aaariyann/Analog-Line-Follower/Anlog_LFR.kicad_pcb

## KiCad design Anlog_LFR.kicad_pcb (2026-10-10)

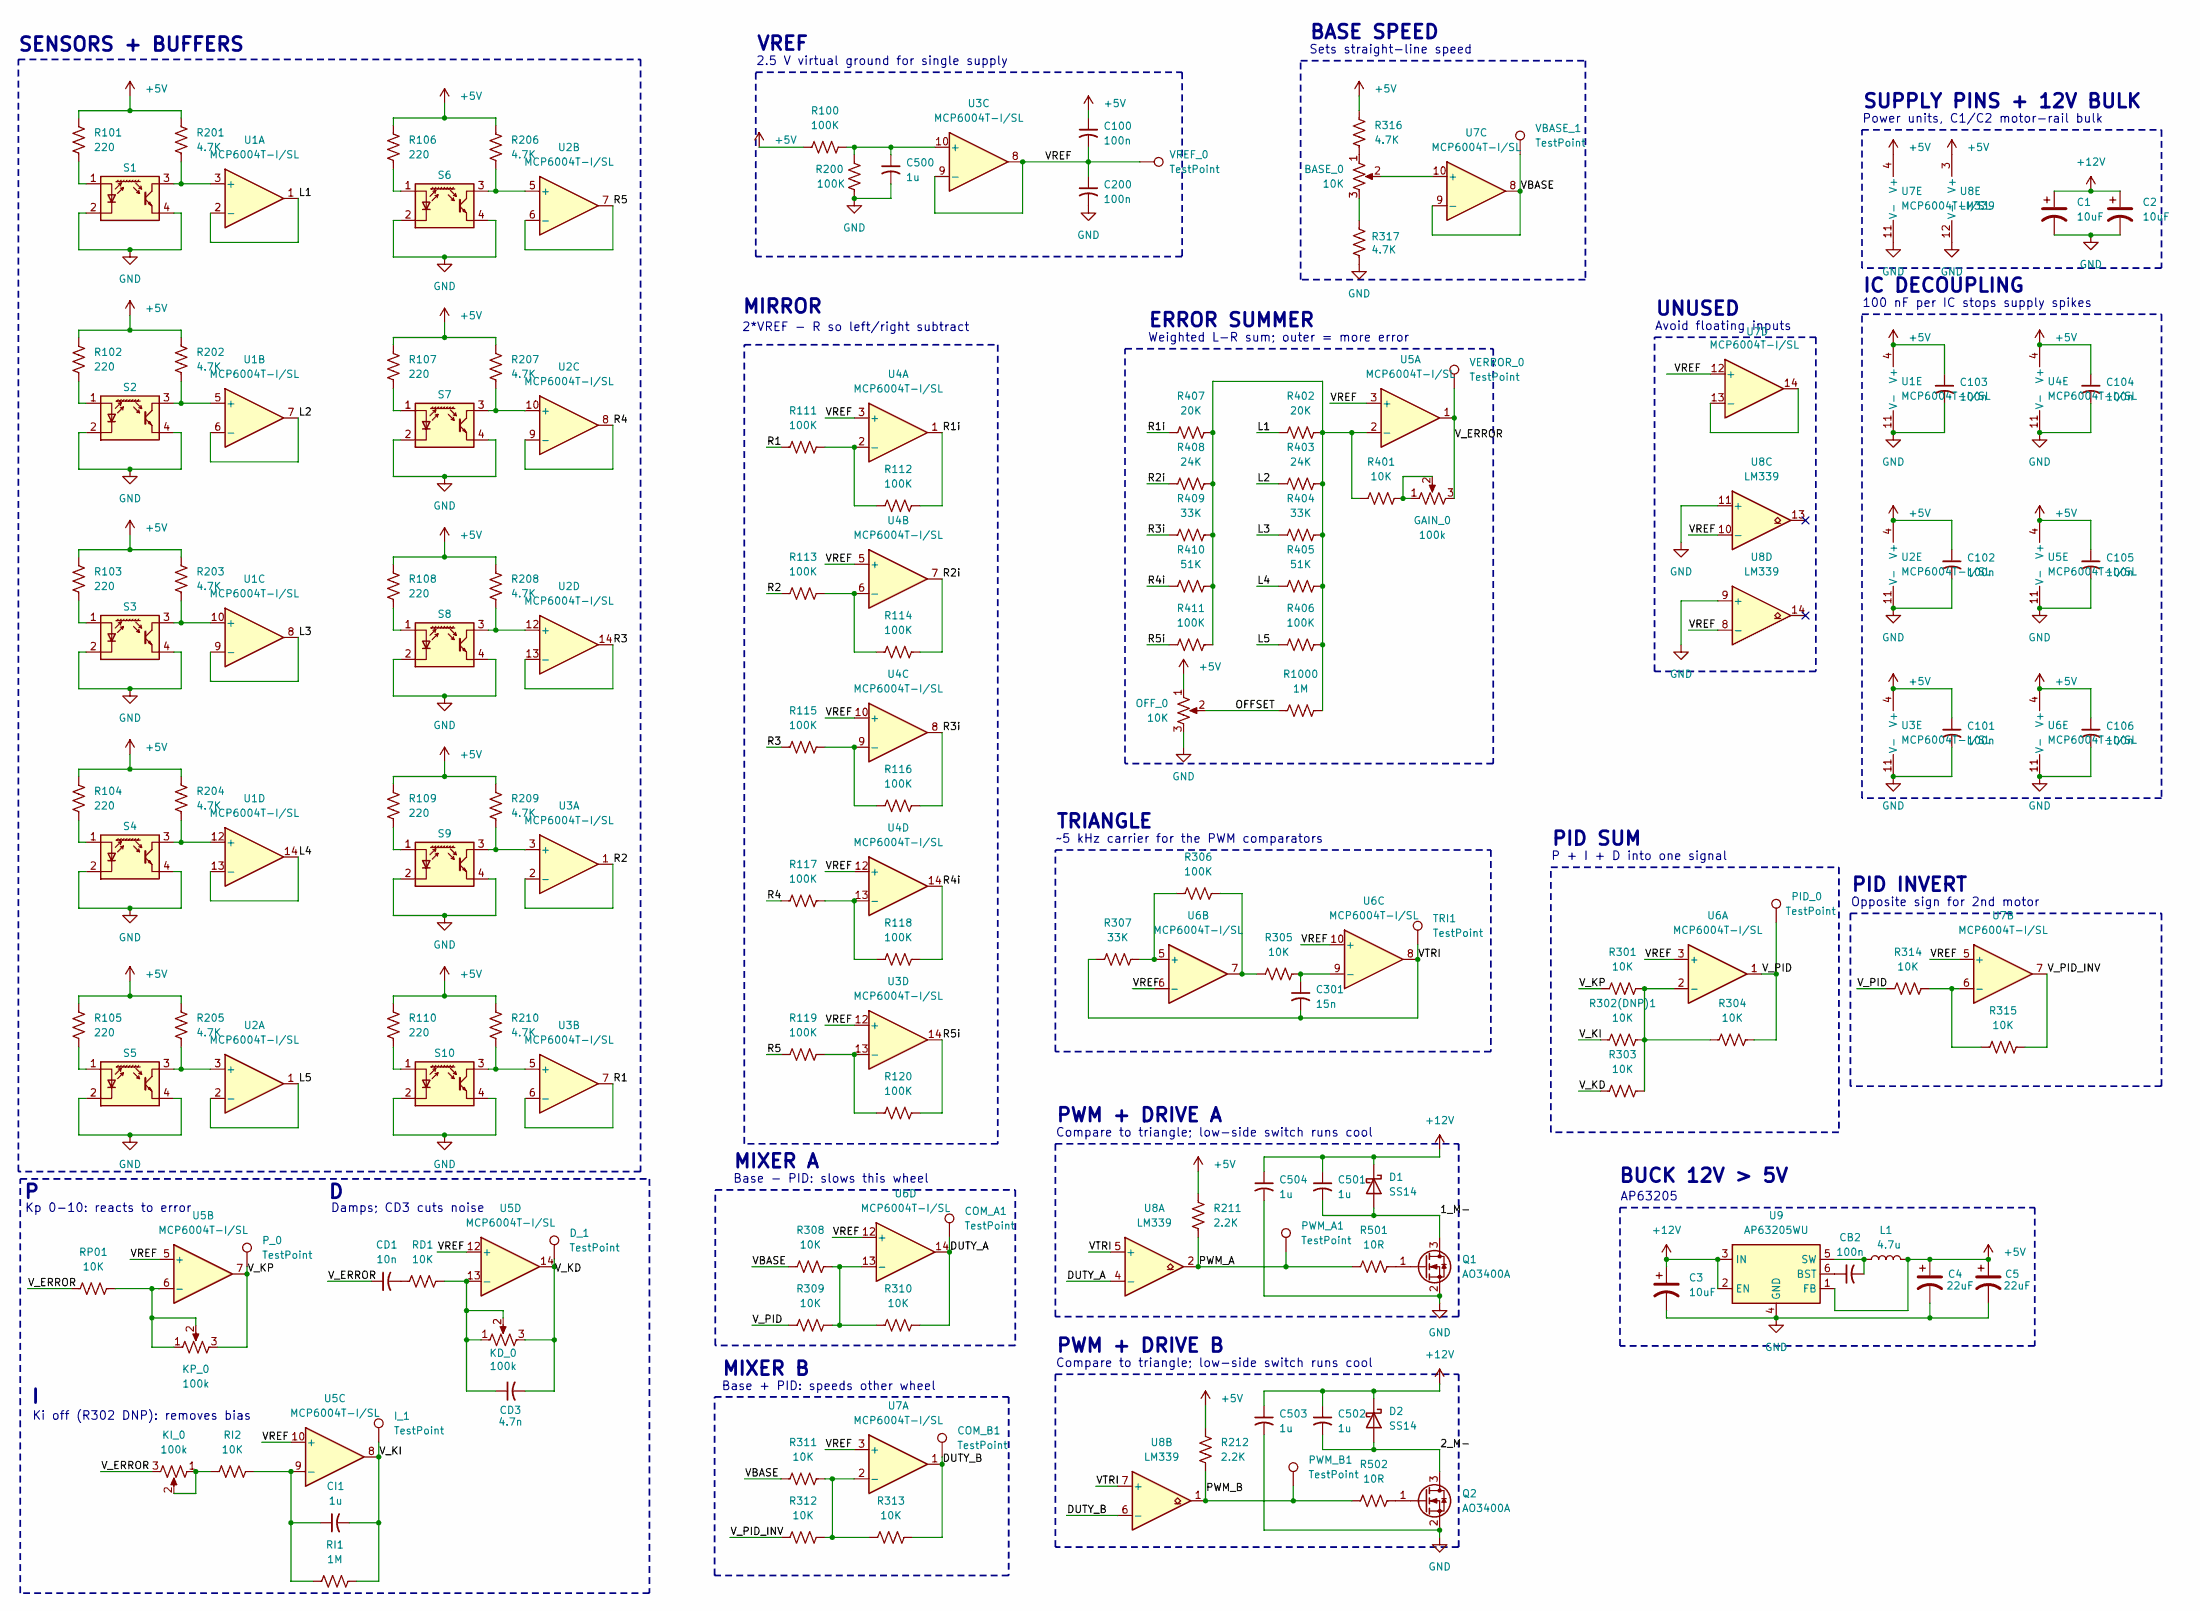
[picture p1: schematic Analog_LFR.kicad_sch, Analog PID Line Follower]

Parts:
BASE_0: 10K; Potentiometer_Bourns_3224W_Vertical
C1, C2: 10uF; CP_Elec_5x5.4
C3: 10uF; C_1206_3216Metric_Pad1.33x1.80mm_HandSolder
C4, C5: 22uF; C_1206_3216Metric_Pad1.33x1.80mm_HandSolder
C100, C101, C102, C103, C104, C105, C106, C200: 100n; C_1206_3216Metric_Pad1.33x1.80mm_HandSolder
C301: 15n; C_0805_2012Metric_Pad1.18x1.45mm_HandSolder
C500, C501, C502, C503, C504: 1u; C_0805_2012Metric_Pad1.18x1.45mm_HandSolder
CB2: 100n; C_1206_3216Metric_Pad1.33x1.80mm_HandSolder
CD1: 10n; C_1206_3216Metric_Pad1.33x1.80mm_HandSolder
CD3: 4.7n; C_1206_3216Metric_Pad1.33x1.80mm_HandSolder
CI1: 1u; C_0805_2012Metric_Pad1.18x1.45mm_HandSolder
COM_A1: TestPoint; TestPoint_Pad_D2.0mm
COM_B1: TestPoint; TestPoint_Pad_D2.0mm
D1, D2: SS14; D_SMA
D_1: TestPoint; TestPoint_Pad_D2.0mm
GAIN_0: 100k; Potentiometer_Bourns_3224W_Vertical
I_1: TestPoint; TestPoint_Pad_D2.0mm
KD_0: 100k; Potentiometer_Bourns_3224W_Vertical
KI_0: 100k; Potentiometer_Bourns_3224W_Vertical
KP_0: 100k; Potentiometer_Bourns_3224W_Vertical
L1: 4.7u; L_7.3x7.3_H3.5
OFF_0: 10K; Potentiometer_Bourns_3224W_Vertical
PID_0: TestPoint; TestPoint_Pad_D2.0mm
PWM_A1: TestPoint; TestPoint_Pad_D2.0mm
PWM_B1: TestPoint; TestPoint_Pad_D2.0mm
P_0: TestPoint; TestPoint_Pad_D2.0mm
Q1, Q2: AO3400A; SOT-23-3
R100, R111, R112, R113, R114, R115, R116, R117, R118, R119, R120, R200, R306, R406, R411: 100K; R_1206_3216Metric_Pad1.30x1.75mm_HandSolder
R101, R102, R103, R104, R105, R106, R107, R108, R109, R110: 220; R_1206_3216Metric_Pad1.30x1.75mm_HandSolder
R201, R202, R203, R204, R205, R206, R207, R208, R209, R210, R316, R317: 4.7K; R_1206_3216Metric_Pad1.30x1.75mm_HandSolder
R211, R212: 2.2K; R_1206_3216Metric_Pad1.30x1.75mm_HandSolder
R301, R302(DNP)1, R303, R304, R305, R308, R309, R310, R311, R312, R313, R314, R315, R401: 10K; R_1206_3216Metric_Pad1.30x1.75mm_HandSolder
R307, R404, R409: 33K; R_1206_3216Metric_Pad1.30x1.75mm_HandSolder
R402, R407: 20K; R_1206_3216Metric_Pad1.30x1.75mm_HandSolder
R403, R408: 24K; R_1206_3216Metric_Pad1.30x1.75mm_HandSolder
R405, R410: 51K; R_1206_3216Metric_Pad1.30x1.75mm_HandSolder
R501, R502: 10R; R_1206_3216Metric_Pad1.30x1.75mm_HandSolder
R1000: 1M; R_1206_3216Metric_Pad1.30x1.75mm_HandSolder
RD1: 10K; R_1206_3216Metric_Pad1.30x1.75mm_HandSolder
RI1: 1M; R_1206_3216Metric_Pad1.30x1.75mm_HandSolder
RI2: 10K; R_1206_3216Metric_Pad1.30x1.75mm_HandSolder
RP01: 10K; R_1206_3216Metric_Pad1.30x1.75mm_HandSolder
S1, S2, S3, S4, S5, S6, S7, S8, S9, S10: QRE1113GR; OnSemi_CASE100CY
TRI1: TestPoint; TestPoint_Pad_D2.0mm
U1, U2, U3, U4, U5, U6, U7: MCP6004T-I/SL; SOIC-14_3.9x8.7mm_P1.27mm
U8: LM339; SOIC-14_3.9x8.7mm_P1.27mm
U9: AP63205WU; TSOT-23-6
VBASE_1: TestPoint; TestPoint_Pad_D2.0mm
VERROR_0: TestPoint; TestPoint_Pad_D2.0mm
VREF_0: TestPoint; TestPoint_Pad_D2.0mm

Connections:
+5V: C4.1, C5.1, C100.1, C101.1, C102.1, C103.1, C104.1, C105.1, C106.1, L1.2, OFF_0.1, R100.1, R101.1, R102.1, R103.1, R104.1, R105.1, R106.1, R107.1, R108.1, R109.1, R110.1, R201.2, R202.2, R203.2, R204.2, R205.2, R206.2, R207.2, R208.2, R209.2, R210.2, R211.2, R212.2, R316.2, U1.4 (V+), U2.4 (V+), U3.4 (V+), U4.4 (V+), U5.4 (V+), U6.4 (V+), U7.4 (V+), U8.3 (V+), U9.1 (FB)
+12V: C1.1, C2.1, C3.1, C501.1, C502.1, C503.1, C504.1, D1.1 (K), D2.1 (K), U9.2 (EN), U9.3 (IN)
/1_M-: C501.2, D1.2 (A), Q1.3 (D)
/2_M-: C502.2, D2.2 (A), Q2.3 (D)
/DUTY_A: COM_A1.1 (1_1), R310.2, U6.14, U8.4 (-)
/DUTY_B: COM_B1.1 (1_1), R313.2, U7.1, U8.6 (-)
/L1: R402.1, U1.1, U1.2 (-)
/L2: R403.1, U1.6 (-), U1.7
/L3: R404.1, U1.8, U1.9 (-)
/L4: R405.1, U1.13 (-), U1.14
/L5: R406.1, U2.1, U2.2 (-)
/OFFSET: OFF_0.2, R1000.1
/PWM_A: PWM_A1.1 (1_1), R211.1, R501.1, U8.2
/PWM_B: PWM_B1.1 (1_1), R212.1, R502.1, U8.1
/R1: R111.1, U3.6 (-), U3.7
/R1i: R112.2, R407.1, U4.1
/R2: R113.1, U3.1, U3.2 (-)
/R2i: R114.2, R408.1, U4.7
/R3: R115.1, U2.13 (-), U2.14
/R3i: R116.2, R409.1, U4.8
/R4: R117.1, U2.8, U2.9 (-)
/R4i: R118.2, R410.1, U4.14
/R5: R119.1, U2.6 (-), U2.7
/R5i: R120.2, R411.1, U3.14
/VBASE: R308.1, R311.1, U7.8, U7.9 (-), VBASE_1.1 (1_1)
/VREF: C100.2, C200.1, U3.8, U3.9 (-), U3.12 (+), U4.3 (+), U4.5 (+), U4.10 (+), U4.12 (+), U5.3 (+), U5.5 (+), U5.10 (+), U5.12 (+), U6.3 (+), U6.6 (-), U6.10 (+), U6.12 (+), U7.3 (+), U7.5 (+), U7.12 (+), U8.8 (-), U8.10 (-), VREF_0.1 (1_1)
/VTRI: C301.2, R307.1, TRI1.1 (1_1), U6.8, U8.5 (+), U8.7 (+)
/V_ERROR: CD1.1, GAIN_0.3, KI_0.3, RP01.1, U5.1, VERROR_0.1 (1_1)
/V_KD: CD3.2, D_1.1 (1_1), KD_0.3, R303.1, U5.14
/V_KI: CI1.2, I_1.1 (1_1), R302(DNP)1.1, RI1.2, U5.8
/V_KP: KP_0.3, P_0.1 (1_1), R301.1, U5.7
/V_PID: PID_0.1 (1_1), R304.2, R309.1, R314.1, U6.1
/V_PID_INV: R312.1, R315.2, U7.7
GND: C1.2, C2.2, C3.2, C4.2, C5.2, C101.2, C102.2, C103.2, C104.2, C105.2, C106.2, C200.2, C500.2, C503.2, C504.2, OFF_0.3, Q1.2 (S), Q2.2 (S), R200.2, R317.1, S1.2 (K), S1.4, S2.2 (K), S2.4, S3.2 (K), S3.4, S4.2 (K), S4.4, S5.2 (K), S5.4, S6.2 (K), S6.4, S7.2 (K), S7.4, S8.2 (K), S8.4, S9.2 (K), S9.4, S10.2 (K), S10.4, U1.11 (V-), U2.11 (V-), U3.11 (V-), U4.11 (V-), U5.11 (V-), U6.11 (V-), U7.11 (V-), U8.9 (+), U8.11 (+), U8.12 (V-), U9.4 (GND)
unnamed: BASE_0.1, R316.1
unnamed: BASE_0.3, R317.2
unnamed: CD1.2, RD1.1
unnamed: GAIN_0.1, GAIN_0.2, R401.2
unnamed: KI_0.1, KI_0.2, RI2.1
unnamed: Q1.1 (G), R501.2
unnamed: Q2.1 (G), R502.2
unnamed: R305.1, R306.2, U6.7
unnamed: R101.2, S1.1 (A)
unnamed: R102.2, S2.1 (A)
unnamed: R103.2, S3.1 (A)
unnamed: R104.2, S4.1 (A)
unnamed: R105.2, S5.1 (A)
unnamed: R106.2, S6.1 (A)
unnamed: R107.2, S7.1 (A)
unnamed: R108.2, S8.1 (A)
unnamed: R109.2, S9.1 (A)
unnamed: R110.2, S10.1 (A)
unnamed: R201.1, S1.3, U1.3 (+)
unnamed: R202.1, S2.3, U1.5 (+)
unnamed: R203.1, S3.3, U1.10 (+)
unnamed: R204.1, S4.3, U1.12 (+)
unnamed: R205.1, S5.3, U2.3 (+)
unnamed: R206.1, S6.3, U2.5 (+)
unnamed: R207.1, S7.3, U2.10 (+)
unnamed: R208.1, S8.3, U2.12 (+)
unnamed: R209.1, S9.3, U3.3 (+)
unnamed: R210.1, S10.3, U3.5 (+)
unnamed: C500.1, R100.2, R200.1, U3.10 (+)
unnamed: R119.2, R120.1, U3.13 (-)
unnamed: R111.2, R112.1, U4.2 (-)
unnamed: R113.2, R114.1, U4.6 (-)
unnamed: R115.2, R116.1, U4.9 (-)
unnamed: R117.2, R118.1, U4.13 (-)
unnamed: R401.1, R402.2, R403.2, R404.2, R405.2, R406.2, R407.2, R408.2, R409.2, R410.2, R411.2, R1000.2, U5.2 (-)
unnamed: KP_0.1, KP_0.2, RP01.2, U5.6 (-)
unnamed: CI1.1, RI1.1, RI2.2, U5.9 (-)
unnamed: CD3.1, KD_0.1, KD_0.2, RD1.2, U5.13 (-)
unnamed: R301.2, R302(DNP)1.2, R303.2, R304.1, U6.2 (-)
unnamed: R306.1, R307.2, U6.5 (+)
unnamed: C301.1, R305.2, U6.9 (-)
unnamed: R308.2, R309.2, R310.1, U6.13 (-)
unnamed: R311.2, R312.2, R313.1, U7.2 (-)
unnamed: R314.2, R315.1, U7.6 (-)
unnamed: BASE_0.2, U7.10 (+)
unnamed: U7.13 (-), U7.14
unnamed: CB2.1, U9.6 (BST)
unnamed: CB2.2, L1.1, U9.5 (SW)

Notes on the sheet:
BUCK 12V > 5V
~5 kHz carrier for the PWM comparators
BASE SPEED
IC DECOUPLING
Weighted L-R sum; outer = more error
PWM + DRIVE A
Kp 0-10: reacts to error
VREF
Damps; CD3 cuts noise
Ki off (R302 DNP): removes bias
SUPPLY PINS + 12V BULK
Avoid floating inputs
MIXER A
SENSORS + BUFFERS
Compare to triangle; low-side switch runs cool
PID INVERT
TRIANGLE
Opposite sign for 2nd motor
AP63205
MIXER B
Power units, C1/C2 motor-rail bulk
Base - PID: slows this wheel
Sets straight-line speed
100 nF per IC stops supply spikes
P + I + D into one signal
PID SUM
UNUSED
PWM + DRIVE B
Base + PID: speeds other wheel
MIRROR
ERROR SUMMER
2.5 V virtual ground for single supply
2*VREF - R so left/right subtract

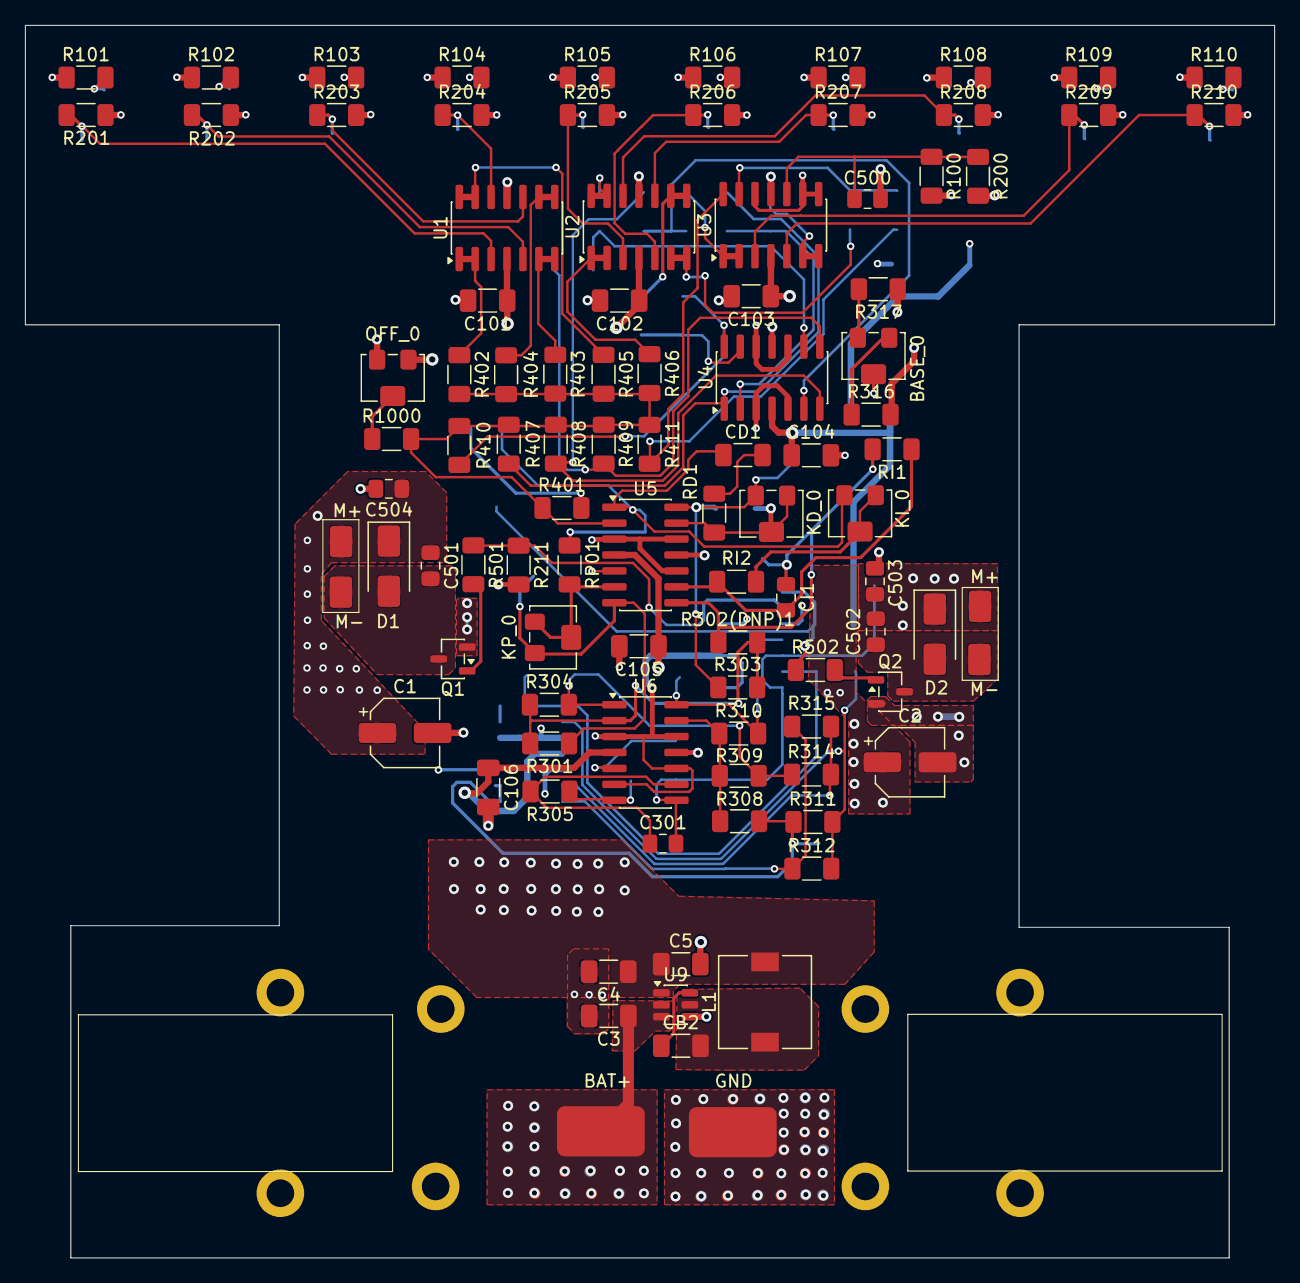
[picture p2: board Anlog_LFR.kicad_pcb from above]

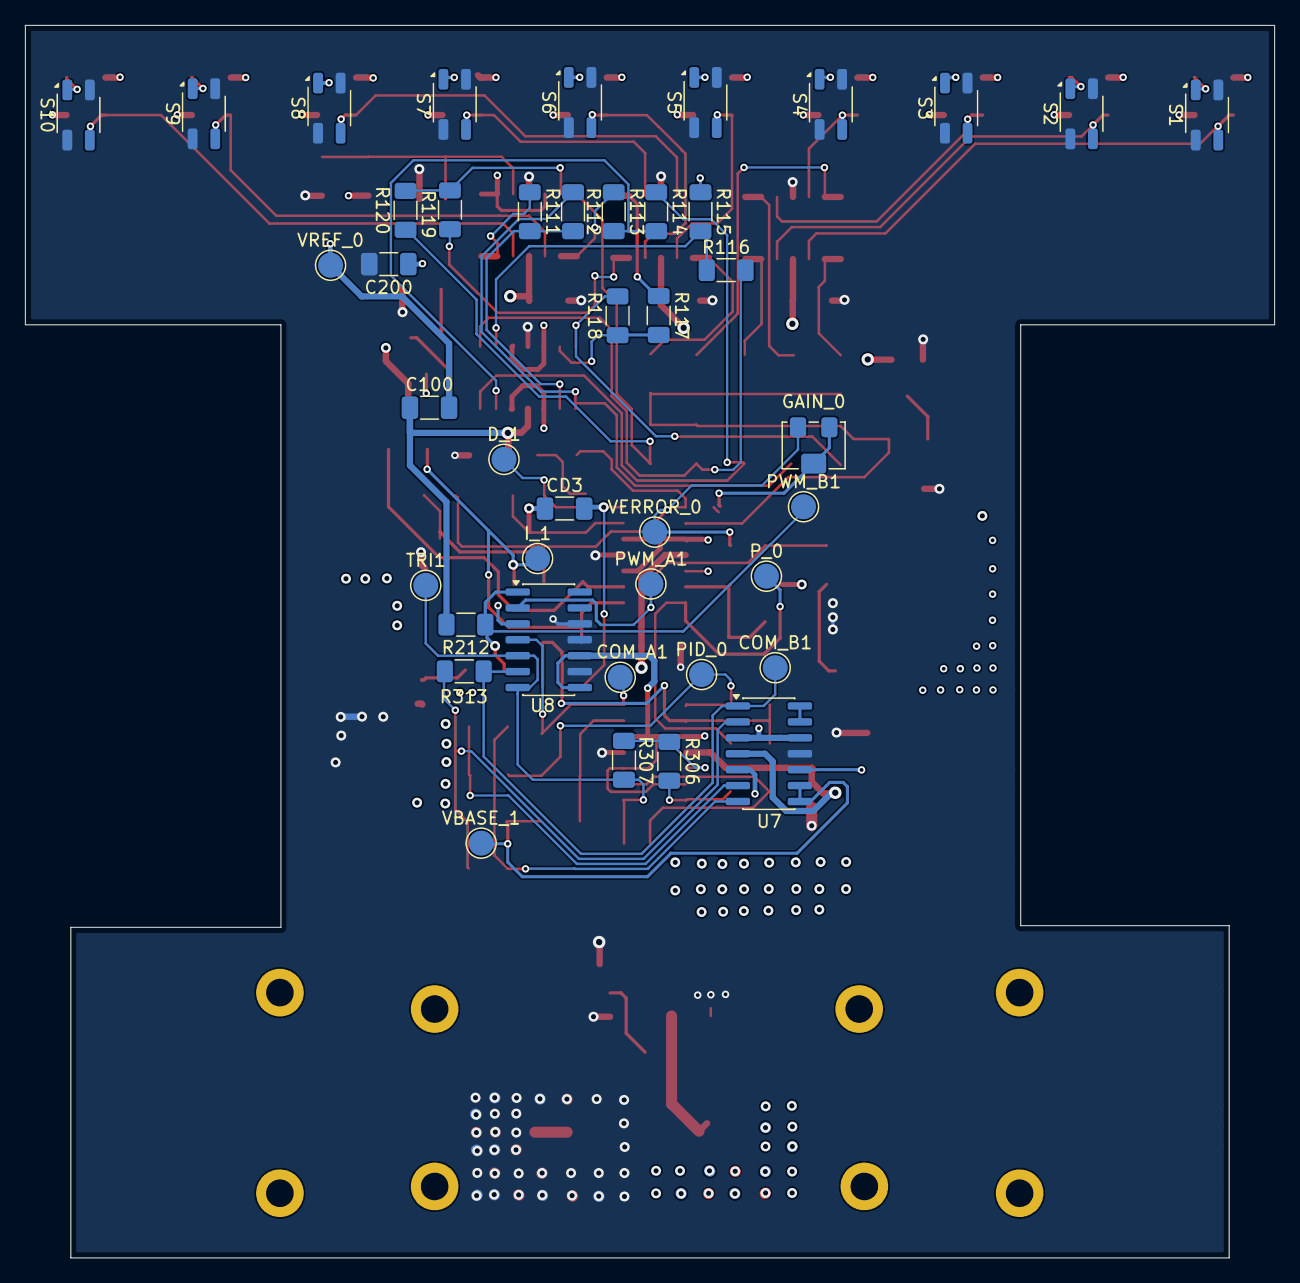
[picture p3: board Anlog_LFR.kicad_pcb from below]

Board: 4 copper layers, 99.6 x 98.3 mm, 134 parts (42 on the bottom side), 82 nets.
