aaariyann/Analog-Line-Follower/(commit log)

2026-10-10 Gate pull up changed for faster switching
    [Analog_LFR.kicad_sch]
2026-10-10 ERROR WEIGHTS FIXED
    [Analog_LFR.kicad_sch, Anlog_LFR.kicad_pcb]
